alitel/DEC-VSXXX-to-PS2-mouse-adapter/DB9SerialPinout.png

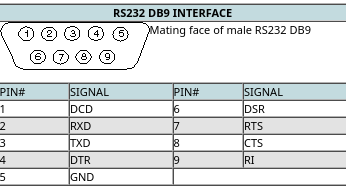
DB9SerialPinout.png
