alitel/DEC-VSXXX-to-PS2-mouse-adapter/PS2MousePinout.png

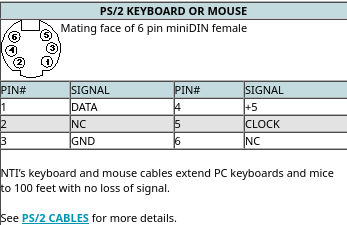
PS2MousePinout.png
